aviaplana/electronic_lock/(list of files, cad)

Other CAD files:
3d_models_motor_version/includes/battery_holder_single.scad
3d_models/includes/gears.scad
