aviaplana/electronic_lock/(commit log)

2015-01-24 Arduino part
2015-01-24 Android part
    [ormlite_config.txt]
2015-01-30 Working version
    [ormlite_config.txt]
2015-02-16 Upgrading to ARDUINO IDE 1.6. Replace Libraries and Hardware folders in you sketchbook location with new ones
    [main.cpp]
2015-02-18 Modified arduino firmware to support servo. The SERVO_STOP_ANGLE constant needs to be determined experimentally.
2015-02-18 Removed the servo lib and added support for directly interfaceing with the servos h-bridge.
2015-02-26 Get rid of the ADCTouch library. Change pin numbers.
2015-03-02 Show some feedback using the LED. Set up BUTTON_PIN as a INPUT_PULLUP.
2015-03-03 Update arduino code to update status on manual user operation
2015-03-03 Fixed a couple of simple but nasty bugs
    [H-Lock.ino]
2015-03-04 Added all the 3d models
    [H-lock.scad, battery_holder_3.scad, battery_holder_single.scad, case.scad, cylinder.scad, electronics.scad, gears.scad, locking_bar.scad]
2015-03-04 Include the hall boxes.
    [case.scad]
2015-03-04 Update comment
    [case.scad]
2015-03-04 Added the motor version of the case. THIS VERSION WAS DISMISSED!
    [H-lock_motor.scad, battery_holder_3.scad, battery_holder_single.scad, case.scad, cylinder.scad, gears.scad, motor.scad]
